paweljur/CS-GO-avr-bomb-replica/Dokumentacja/Prezentacja.pdf

# Replika bomby z gry Counter Strike Global Offensive

Autor: | Paweł Jur
Rok: | 2018/2019
Semestr: 5
Grupa: | 1
Sekcja: | 1

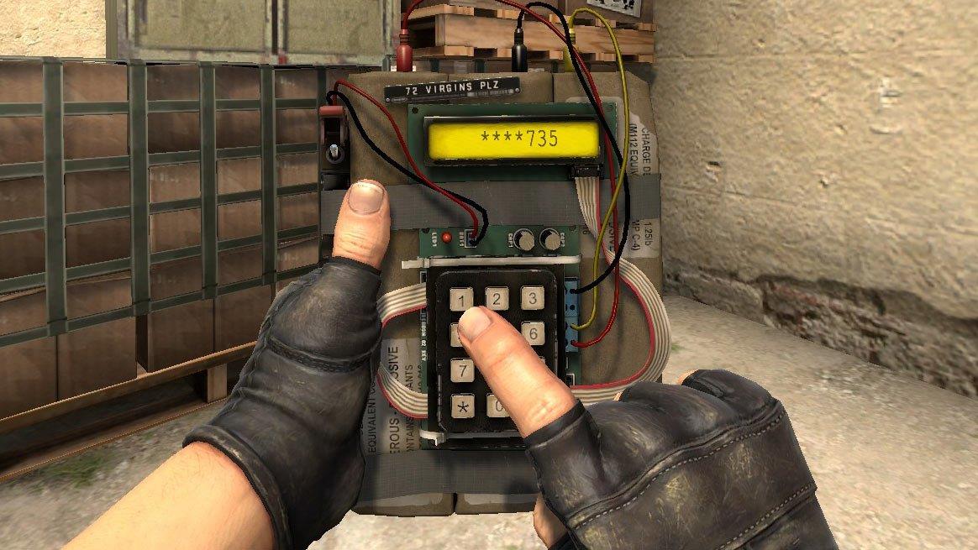
[picture p1: page 2]

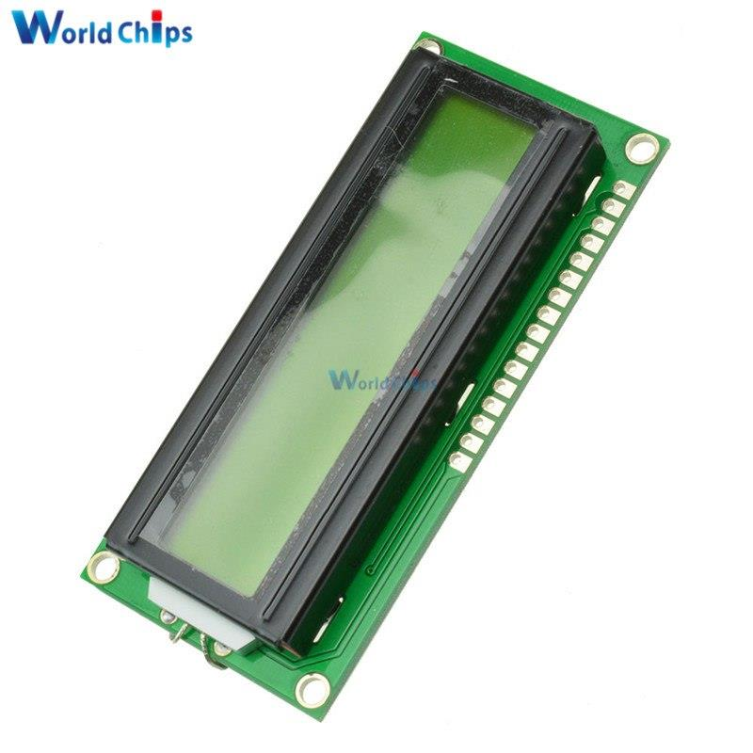
[picture p2: figure]

# Wyświetlacz

- Sterownik SPLC780D
- 1x16 znaków
- Żółte podświetlenie

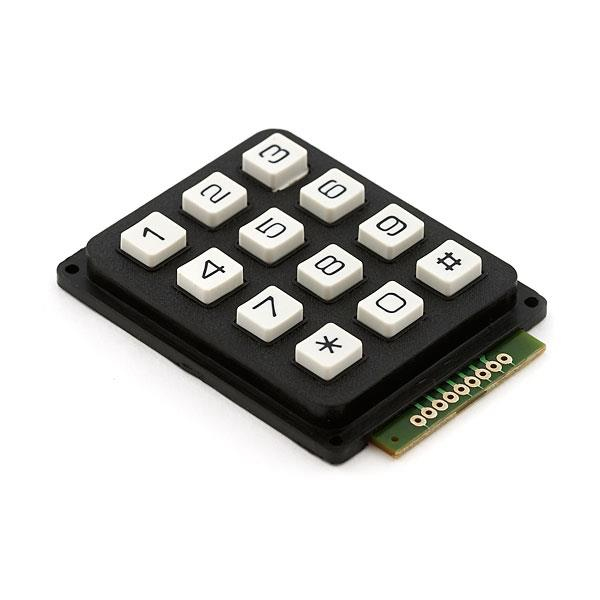
[picture p3: figure]

# Klawiatura matrycowa

- Uruchamianie bomby z kodem rozbrajającym
- Rozbrajanie bomby kodem początkowym
- 12 przycisków w ułożeniu 4x3

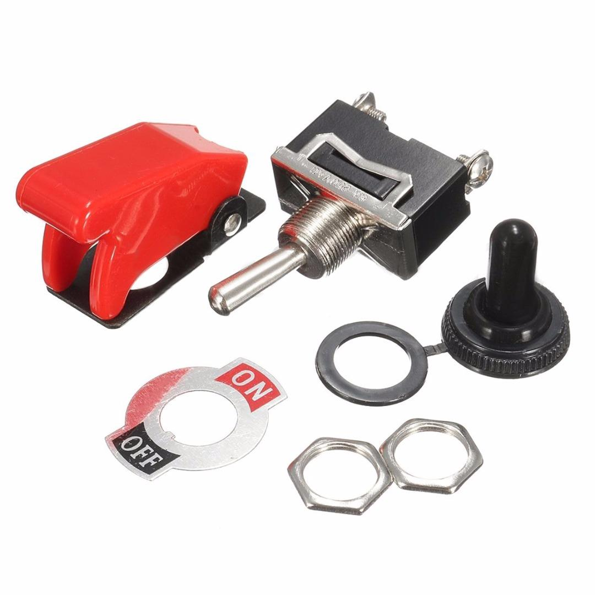
[picture p4: figure]

# Piękny przełącznik

- Ładny czerwony
- Zasilanie 9V
- Oszczędzanie baterii

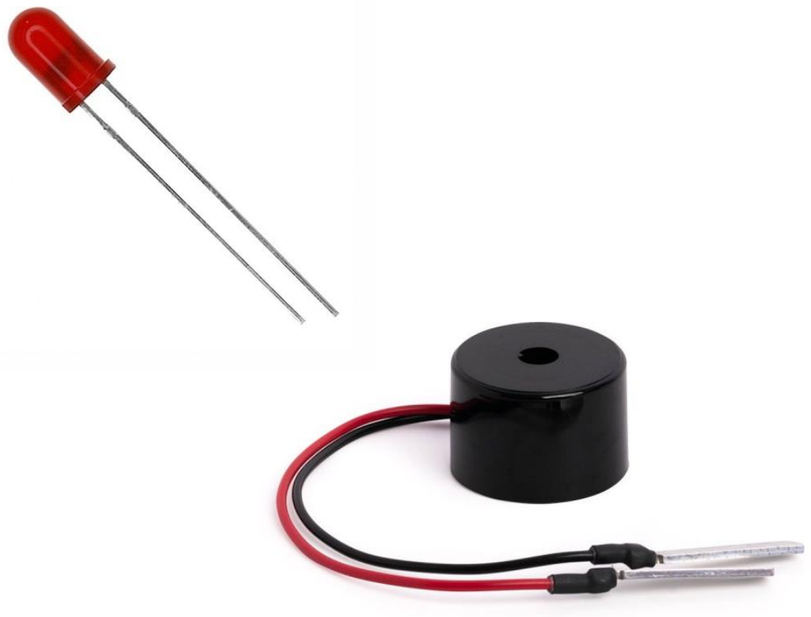
[picture p5: figure]

# Powiadomienia

- Mrugająca dioda czerwona/RGB
- Głośniczek sterowany timerem
- Zmniejszające się interwały międzyczasowe

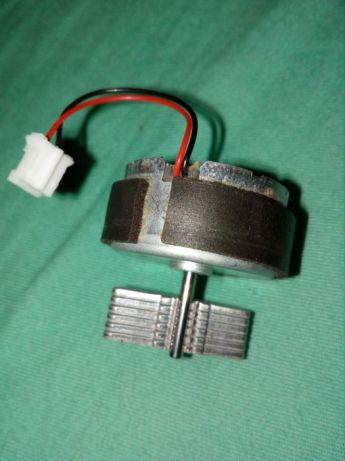
[picture p6: figure]

# Symulacja wybuchu

- Silniczek wibrujący
- Kontroler XBOX
- 2-3 V

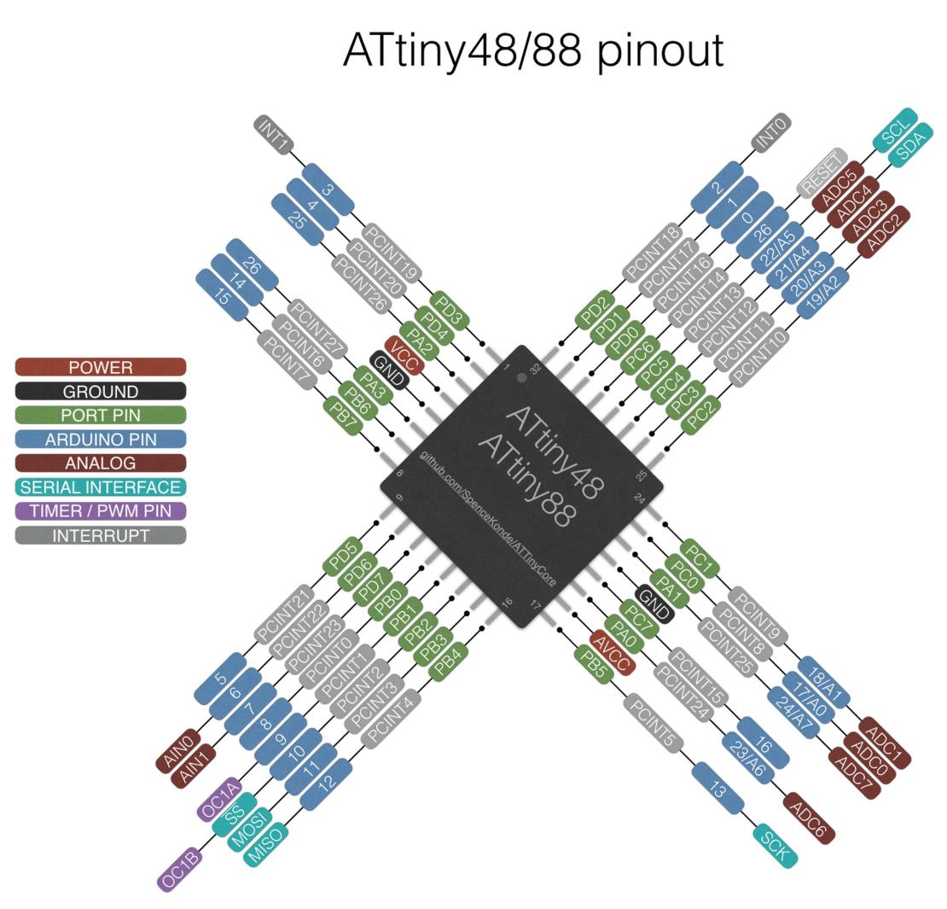
[picture p7: figure]

# Mikrokontroler ATtiny48/88

- 24/28 programowalnych pinów
- Jeden 8 bitowy licznik
- Jeden 16 bitowy licznik
- Częstotliwość do 12 MHz
