paweljur/CS-GO-avr-bomb-replica/Hardware/Schemat.pdf

KEYBOARD | BATTERY | PROGRAMMER | LCD

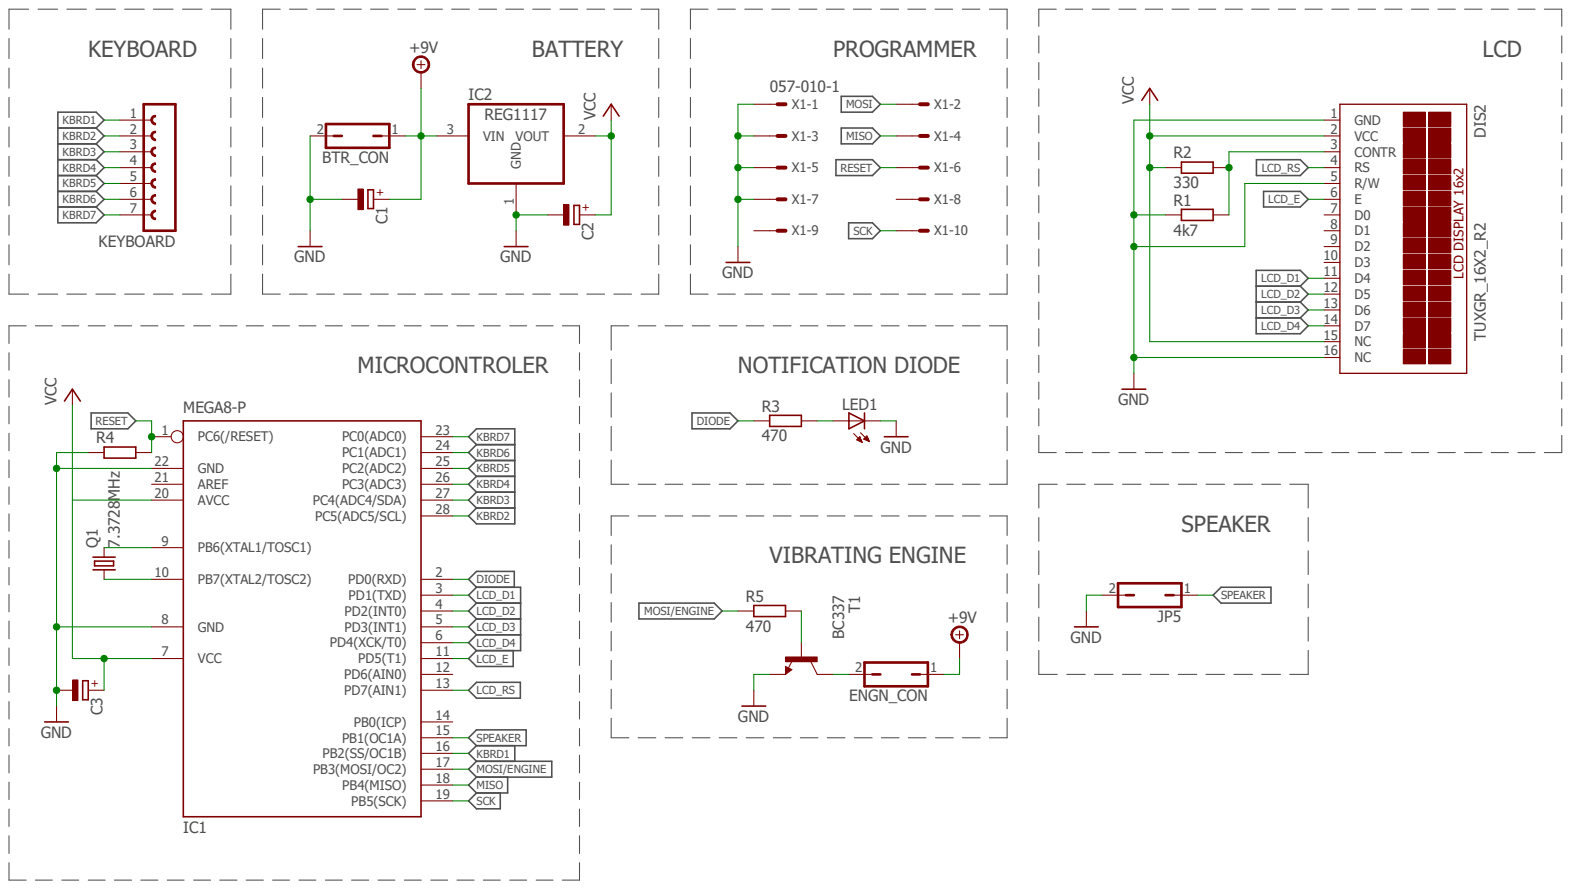
[picture p12: page 1]
