paweljur/CS-GO-avr-bomb-replica/Hardware/Schemat.sch

## EAGLE design Hardware/Schemat.sch (2019-02-10)

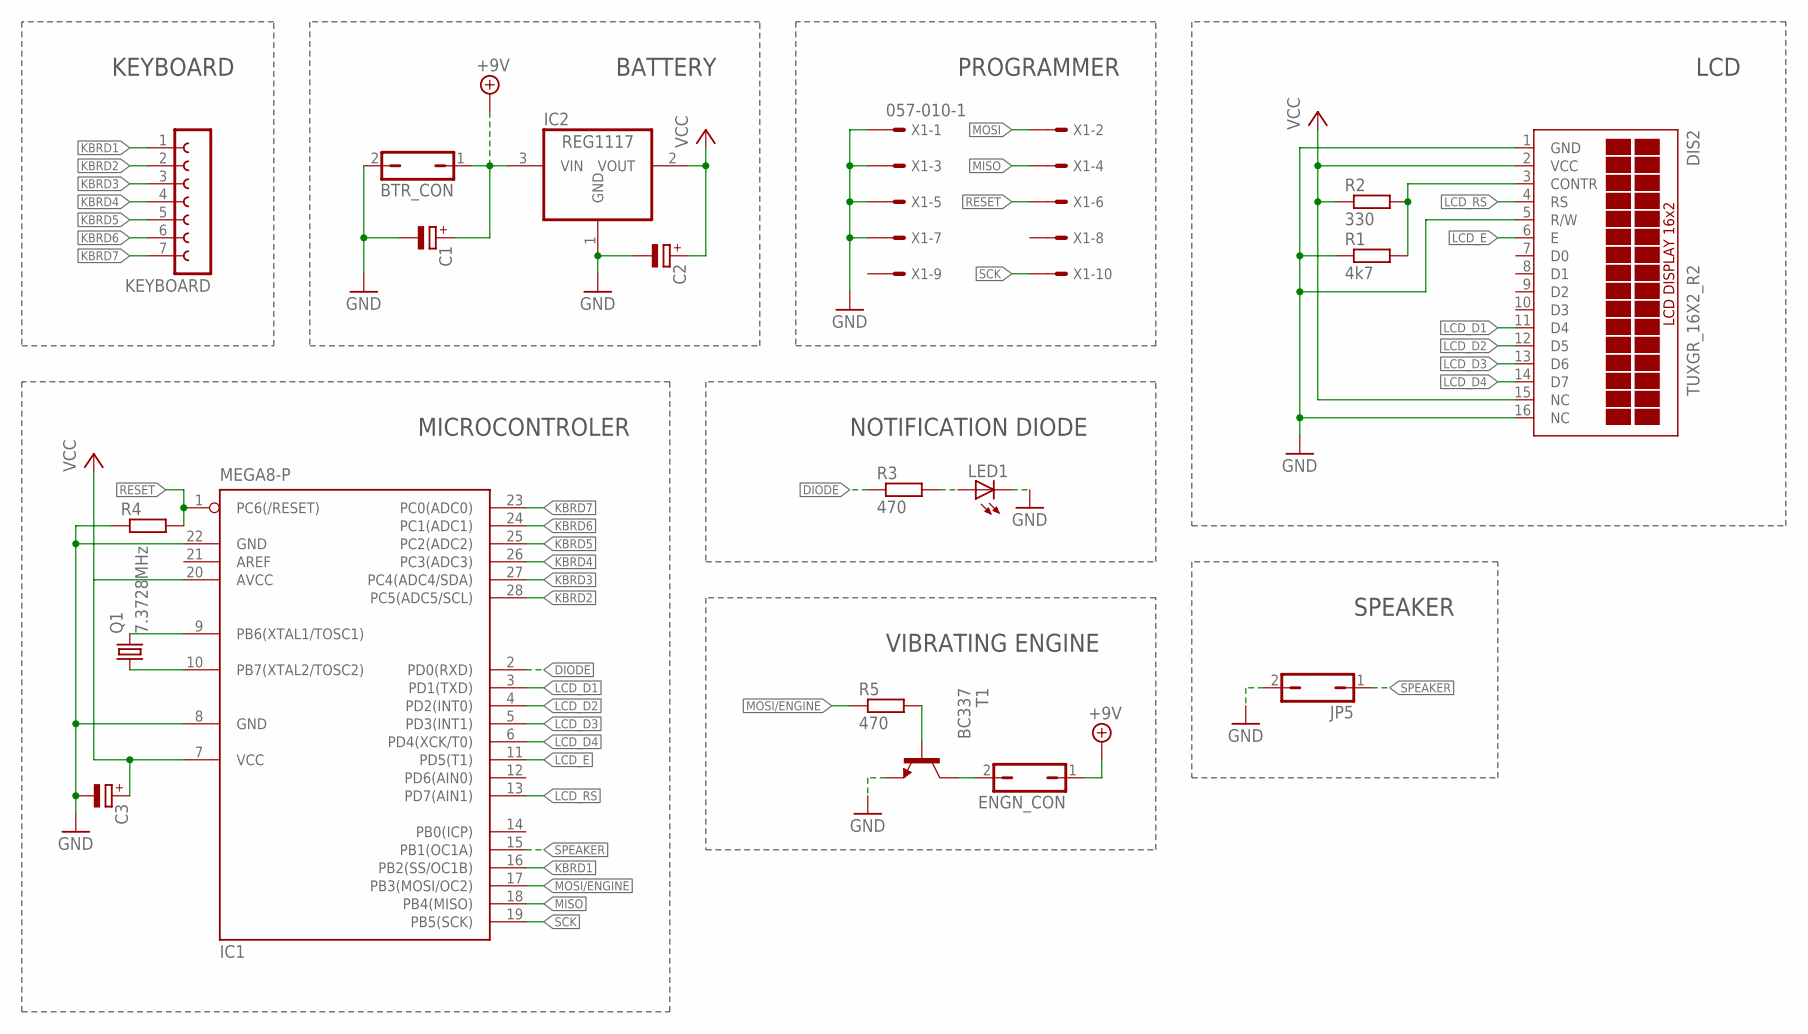
[picture p13: schematic Schemat.sch]

Parts:
BTR_CON: JP1Q; JP1
C1, C2, C3: CPOL-EU139CLL-2R; 139CLL-2R
DIS2: TUXGR_16X2_R2
ENGN_CON: JP1Q; JP1
IC1: MEGA8-P; DIL28-3
IC2: REG1117; SOT223
JP5: JP1Q; JP1
KEYBOARD: FE07-1; FE07
LED1: LED3MM
Q1: 7.3728MHz; HC49/S
R1: 4k7; 0207/7
R2: 330; 0207/7
R3, R5: 470; 0207/7
R4: R-EU_0207/7; 0207/7
T1: BC337; TO92
X1: 057-010-1

Connections:
+9V: BTR_CON.1, C1.+, ENGN_CON.1, IC2.3 (VIN)
DIODE: IC1.2 (PD0(RXD)), R3.1
GND: BTR_CON.2, C1.-, C2.-, C3.-, DIS2.1 (GND), DIS2.5 (R/W), DIS2.16 (NC), IC1.8 (GND), IC1.22 (GND), IC2.1 (GND), JP5.2, LED1.K (C), R1.1, R4.1, T1.1 (E), X1.1, X1.3, X1.5, X1.7
KBRD1: IC1.16 (PB2(SS/OC1B)), KEYBOARD.1
KBRD2: IC1.28 (PC5(ADC5/SCL)), KEYBOARD.2
KBRD3: IC1.27 (PC4(ADC4/SDA)), KEYBOARD.3
KBRD4: IC1.26 (PC3(ADC3)), KEYBOARD.4
KBRD5: IC1.25 (PC2(ADC2)), KEYBOARD.5
KBRD6: IC1.24 (PC1(ADC1)), KEYBOARD.6
KBRD7: IC1.23 (PC0(ADC0)), KEYBOARD.7
LCD_D1: DIS2.11 (D4), IC1.3 (PD1(TXD))
LCD_D2: DIS2.12 (D5), IC1.4 (PD2(INT0))
LCD_D3: DIS2.13 (D6), IC1.5 (PD3(INT1))
LCD_D4: DIS2.14 (D7), IC1.6 (PD4(XCK/T0))
LCD_E: DIS2.6 (E), IC1.11 (PD5(T1))
LCD_RS: DIS2.4 (RS), IC1.13 (PD7(AIN1))
MISO: IC1.18 (PB4(MISO)), X1.4
MOSI: X1.2
MOSI/ENGINE: IC1.17 (PB3(MOSI/OC2)), R5.1
unnamed: IC1.9 (PB6(XTAL1/TOSC1)), Q1.2
unnamed: IC1.10 (PB7(XTAL2/TOSC2)), Q1.1
unnamed: DIS2.3 (CONTR), R1.2, R2.2
unnamed: ENGN_CON.2, T1.3 (C)
unnamed: LED1.A, R3.2
unnamed: C3.+, IC1.7 (VCC)
unnamed: R5.2, T1.2 (B)
RESET: IC1.1 (PC6(/RESET)), R4.2, X1.6
SCK: IC1.19 (PB5(SCK)), X1.10
SPEAKER: IC1.15 (PB1(OC1A)), JP5.1
VCC: C2.+, DIS2.2 (VCC), DIS2.15 (NC), IC1.20 (AVCC), IC2.2 (VOUT), R2.1

Notes on the sheet:
MICROCONTROLER
LCD
PROGRAMMER
BATTERY
KEYBOARD
NOTIFICATION DIODE
VIBRATING ENGINE
SPEAKER
