paweljur/CS-GO-avr-bomb-replica/(commit log)

2019-01-13 Added notification diode
2019-01-13 Implemented Timer 1
2019-01-13 Timer 1 supports speaker
2019-01-25 Added vibrator and fixed delays
    [main.c]
2019-02-10 Prepared structure for zmitac
    [Schemat.sch]
